agarnung/srinivasa-says/(list of files, drawings)

Other design files:
SrinivasaSays.pdsprj
